jonathan-iap/MiniVarioL0/PCB/README.md

Tool_Kicad-EmptyProject
===============

Empty project for new project based on Kicad
