jonathan-iap/MiniVarioL0/PCB/FAB/BOM/MiniVarioL0_B1.ods

Project |  | MiniVarioL0
Gerber Version |  | v1.0.0
BOM Version |  | B1
PCB Class |  |  |  |  | STACKUP (EuroCircuits dimension en µm)
Epaisseur (mm) |  | 1,6 |  |  | MC4 1.6 | 1 | Cu – SIGNAL |  |  | 35
Track & cleareance min(mm) |  | 150/150 |  |  |  |  | Prepeg (12+18) |  |  | 200
Via Hole min (mm) |  | 0,25 |  |  |  |  | prepeg
Via diam min (mm) |  | 0,6 |  |  |  | 2 | Cu int – GND | 18 |  | 20
PCB color |  | green |  |  |  |  | Core FR4 |  |  | 1065
PCB Dimension (mm) |  | 73.00 x 61.00
Impedance Control |  | no |  |  |  | 3 | Cu int – POWER | 18 |  | 20
 |  |  |  |  |  |  | Prepeg (12+18) |  |  | 200
 |  |  |  |  |  |  | 0,20 mm (1 x 2116 1 x 1080) | 200
 |  |  |  |  |  | 4 | Cu– SIGNAL | 18 |  | 35
 |  |  |  |  |  |  |  |  |  | 1575
id | Component |  | Description |  |  | Case |  | Manufacturer | Reference man |  | quantity | datasheet
1 | BT1 |  | Holder for battery coin cell |  |  | CellCoin_BK-912 |  |  | BK-912 |  | 1
6 | C1,C2,C3,C4 |  | CAP CER 10nF 10 % | CAP CER 10nF 10 % |  | C_0402 |  |  |  |  | 4
7 | C5,C12 |  | CAP CER 10µF 10 % | CAP CER 10µF 10 % |  | C_0603 |  |  |  |  | 2
8 | C6,C7,C8,C9,C10,C11,C13,C14 |  | CAP CER 100nF 10 % | CAP CER 100nF 10 % |  | C_0402 |  |  |  |  | 8
9 | D1,D2 |  | D_Schottky | D_Schottky |  | D_0603 |  |  |  |  | 2
10 | D3 |  | LED | LED |  | LED_0603 |  |  |  |  | 1
11 | FB1 |  | Ferrite_Bead | Ferrite_Bead |  | L_0603 |  |  |  |  | 1
13 | LS1 |  | Speaker_Crystal | Speaker_Crystal |  | Buzzer_PKLCS1212E |  |  | PKLCS1212E |  | 1
14 | Q1 |  | Dual mosfet NP-chan 20V | Dual mosfet NP-chan 20V |  | TSOT-23-6 |  |  | DMC2053UVT |  | 1
15 | R1,R2,R3 |  | RES 1M 1 % 63mW | RES 1M 1 % 63mW |  | R_0402 |  |  |  |  | 3
16 | U3 |  | Barometric Pressure Sensor | Barometric Pressure Sensor |  | LGA-8_3x5mm_Pitch1.25mm |  |  | MS5611-01BA |  | 1
2 | U2 |  | IC MCU 32BIT 64KB FLASH | IC MCU 32BIT 64KB FLASH |  | QFN-32-1EP_5x5mm_Pitch0.5mm |  |  | STM32L071KBUx |  | 1
3 | U1 |  | Piezo sound driver | PAM8904JER |  | UQFN-16-1EP_3x3mm_Pitch0.5mm |  |  | PAM8904JER |  | 1
5 | SW4,SW3,SW1 |  | SW_Push_Dual | SW_Push_Dual |  | KMS233G |  |  | KMS233G |  | 3
 |  |  |  |  |  |  |  |  |  |  | 30
Difference from BOM : B1 to B ?
Remove |  | Add |  | Value changed
