jonathan-iap/MiniVarioL0/PCB/FAB/PDF/MiniVario-B_Fab.pdf

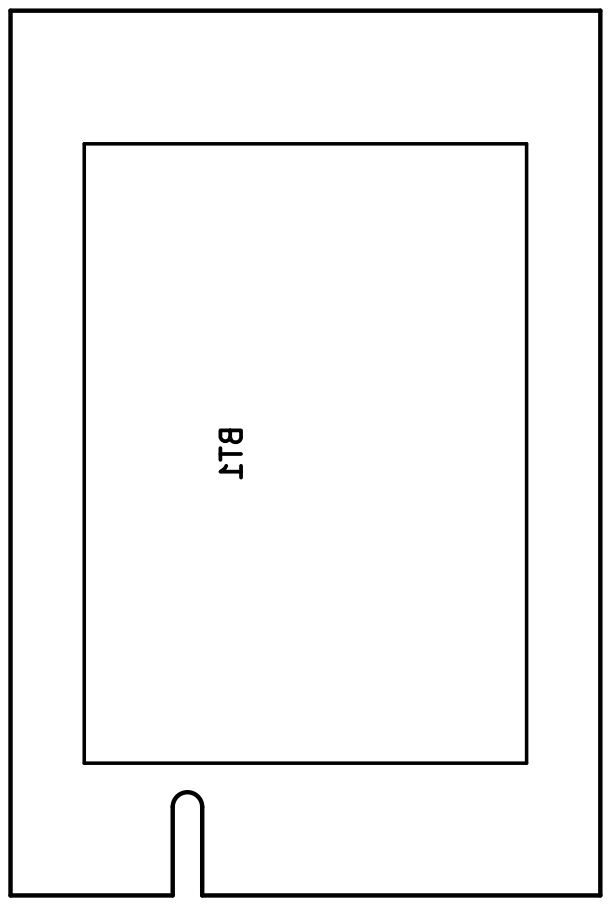
[picture p1: page 1]

File: MiniVario.kicad_pcb Sheet: Jonathan IAPICCO BT1
