jonathan-iap/MiniVarioL0/PCB/FAB/PDF/MiniVario-F_Fab.pdf

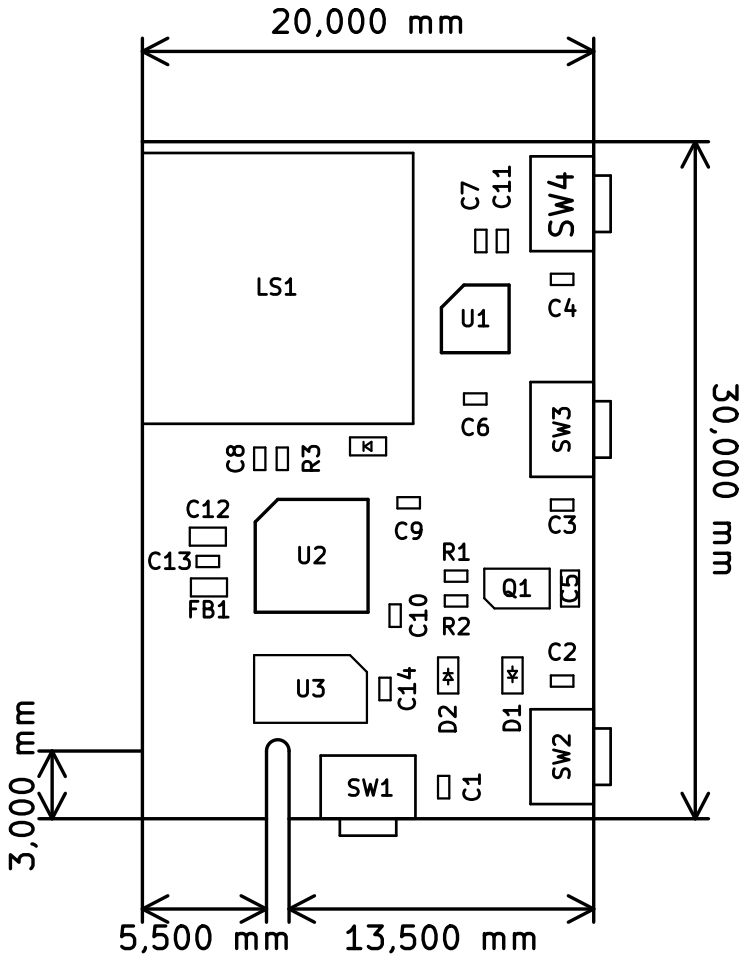
[picture p2: page 1]

File: MiniVario.kicad_pcb Sheet: Jonathan IAPICCO 3,000 mm
