jonathan-iap/MiniVarioL0/PCB/MiniVarioL0.kicad_pcb

## KiCad design PCB/MiniVarioL0.kicad_pcb (2019-11-09)

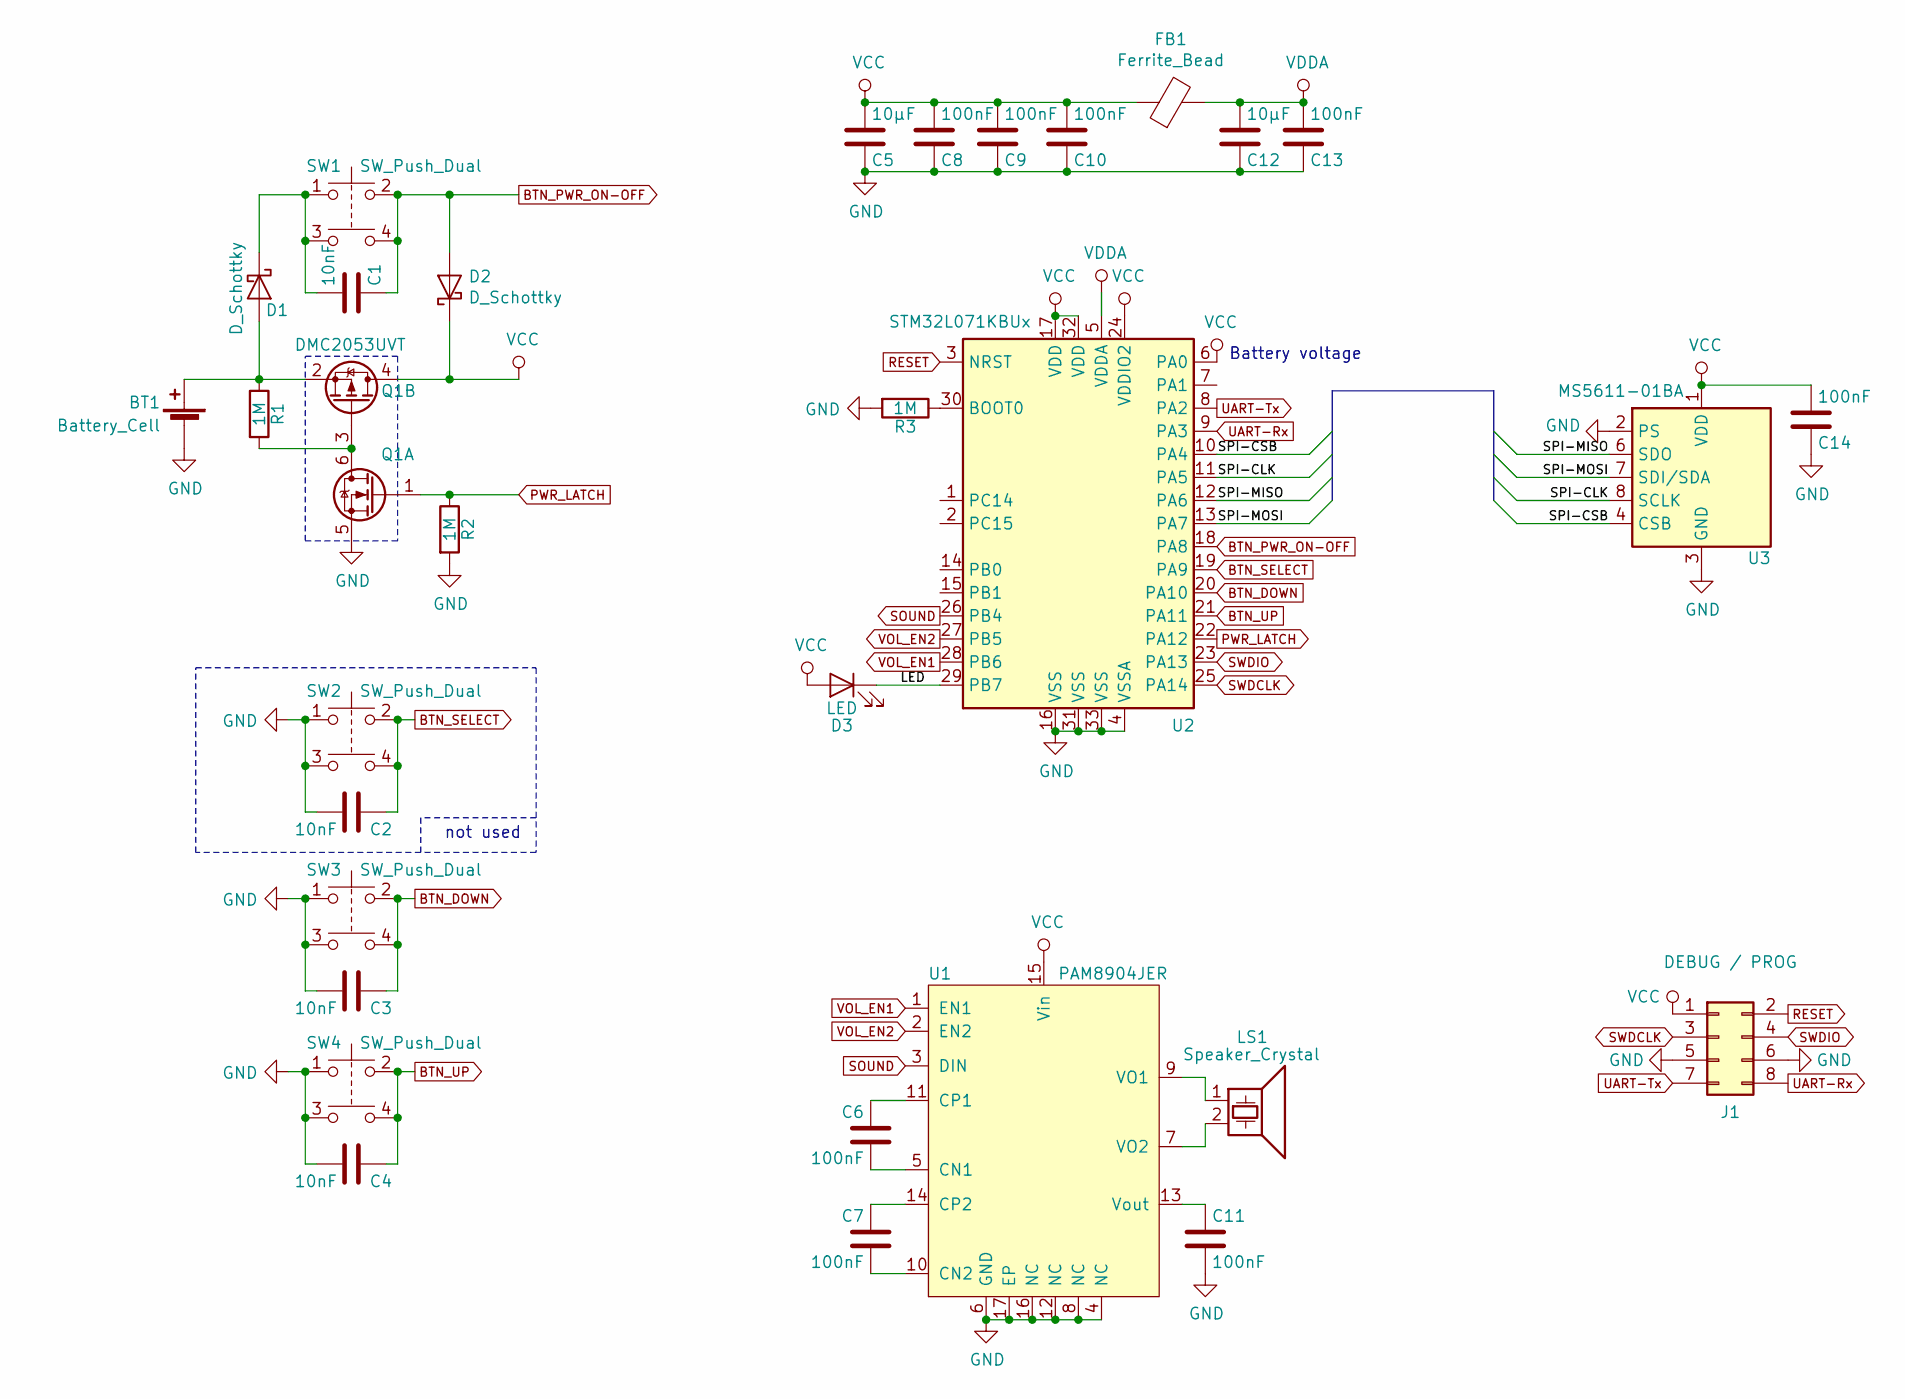
[picture p3: schematic MiniVarioL0.sch]

Parts:
BT1: Battery_Cell; CellCoin_BK-912
C1, C2, C3, C4: 10nF; C_0402
C5, C12: 10µF; C_0603
C6, C7, C8, C9, C10, C11, C13, C14: 100nF; C_0402
D1, D2: D_Schottky; D_0603
D3: LED; LED_0603
FB1: Ferrite_Bead; L_0603
J1: DEBUG / PROG; Conn_Debug
LS1: Speaker_Crystal; Buzzer_PKLCS1212E
Q1: DMC2053UVT; TSOT-23-6
R1, R2, R3: 1M; R_0402
SW1, SW2, SW3, SW4: SW_Push_Dual; PushButton_KMS233G
U1: PAM8904JER; UQFN-16-1EP_3x3mm_Pitch0.5mm
U2: STM32L071KBUx; QFN-32-1EP_5x5mm_Pitch0.5mm
U3: MS5611-01BA; LGA-8_3x5mm_Pitch1.25mm

Connections:
/LED: D3.1 (K), U2.29 (PB7)
/SPI-CLK: U2.11 (PA5), U3.8 (SCLK)
/SPI-CSB: U2.10 (PA4), U3.4 (CSB), U3.5 (CSB)
/SPI-MISO: U2.12 (PA6), U3.6 (SDO)
/SPI-MOSI: U2.13 (PA7), U3.7 (SDI/SDA)
BTN_DOWN: C3.1, SW3.2, SW3.4, U2.20 (PA10)
BTN_PWR_ON-OFF: C1.1, D2.2 (A), SW1.2, SW1.4, U2.18 (PA8)
BTN_SELECT: C2.1, SW2.2, SW2.4, U2.19 (PA9)
BTN_UP: C4.1, SW4.2, SW4.4, U2.21 (PA11)
GND: BT1.2 (-), C2.2, C3.2, C4.2, C5.1, C8.1, C9.1, C10.1, C11.2, C12.1, C13.1, C14.1, J1.5, J1.6, Q1.5 (S), R2.2, R3.2, SW2.1, SW2.3, SW3.1, SW3.3, SW4.1, SW4.3, U1.4 (NC), U1.6 (GND), U1.8 (NC), U1.12 (NC), U1.16 (NC), U1.17 (EP), U2.4 (VSSA), U2.16 (VSS), U2.31 (VSS), U2.33 (VSS), U3.2 (PS), U3.3 (GND)
unnamed: BT1.1 (+), D1.2 (A), Q1.2 (S), R1.1
unnamed: C1.2, D1.1 (K), SW1.1, SW1.3
unnamed: C6.1, U1.11 (CP1)
unnamed: C6.2, U1.5 (CN1)
unnamed: C7.1, U1.14 (CP2)
unnamed: C7.2, U1.10 (CN2)
unnamed: C11.1, U1.13 (Vout)
unnamed: LS1.1, U1.9 (VO1)
unnamed: LS1.2, U1.7 (VO2)
unnamed: Q1.3 (G), Q1.6 (D), R1.2
unnamed: R3.1, U2.30 (BOOT0)
PWR_LATCH: Q1.1 (G), R2.1, U2.22 (PA12)
RESET: J1.2, U2.3 (NRST)
SOUND: U1.3 (DIN), U2.26 (PB4)
SWDCLK: J1.3, U2.25 (PA14)
SWDIO: J1.4, U2.23 (PA13)
UART-Rx: J1.8, U2.9 (PA3)
UART-Tx: J1.7, U2.8 (PA2)
VCC: C5.2, C8.2, C9.2, C10.2, C14.2, D2.1 (K), D3.2 (A), FB1.1, J1.1, Q1.4 (D), U1.15 (Vin), U2.6 (PA0), U2.17 (VDD), U2.24 (VDDIO2), U2.32 (VDD), U3.1 (VDD)
VDDA: C12.2, C13.2, FB1.2, U2.5 (VDDA)
VOL_EN1: U1.1 (EN1), U2.28 (PB6)
VOL_EN2: U1.2 (EN2), U2.27 (PB5)

Notes on the sheet:
Battery voltage
not used

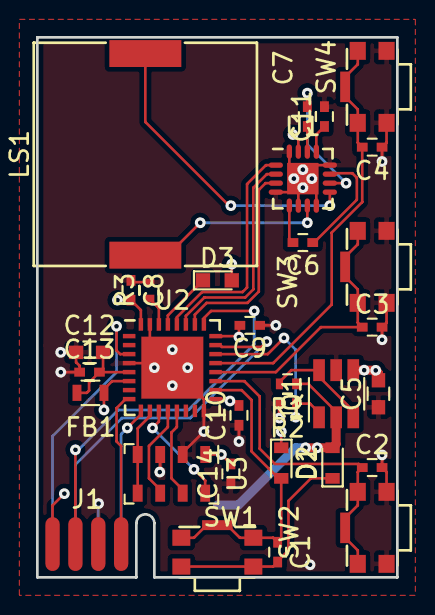
[picture p4: board MiniVarioL0.kicad_pcb from above]

Board: 4 copper layers, 20.0 x 30.0 mm, 32 parts (1 on the bottom side), 32 nets.
