jonathan-iap/MiniVarioL0/Software/Src/main.c

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

/* Includes ------------------------------------------------------------------*/
#include "main.h"
#include "adc.h"
#include "usart.h"
#include "spi.h"
#include "tim.h"
#include "gpio.h"
/* USER CODE BEGIN Includes */
#include "stdio.h"
#include "Peripherals/MS56xx.h"
#include "Peripherals/Tone.h"
#include "Peripherals/UserButtons.h"
#include "Peripherals/Power.h"
#include "Middleware/Macro.h"
#include "Middleware/CheckingHardware.h"
#include "Middleware/Vario.h"
/* USER CODE END Includes */


void SystemClock_Config(void);
/**
 * @brief  The application entry point.
 * @retval int
 */
int main(void)
{
	/* MCU Configuration--------------------------------------------------------*/

	/* Reset of all peripherals, Initializes the Flash interface and the Systick. */
	HAL_Init();

	/* Configure the system clock */
	SystemClock_Config();

	/* Initialize all configured peripherals */
	MX_GPIO_Init();
	MX_SPI1_Init();
	MX_LPUART1_UART_Init();
	MX_ADC_Init();
	MX_TIM3_Init();
	/* USER CODE BEGIN 2 */
#ifdef HARDWARE_TESTING

	checkingHardware(); // Help for new device assembly

	while(1)
	{
		HAL_GPIO_TogglePin(LED_GPIO_Port, LED_Pin);
		HAL_Delay(500);
	}
#endif

	welcome();
	/* USER CODE END 2 */

	/* Infinite loop */
	/* USER CODE BEGIN WHILE */
	while (1)
	{
		varioRun();
		/* USER CODE END WHILE */

		/* USER CODE BEGIN 3 */
	}
	/* USER CODE END 3 */
}

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
