jonathan-iap/MiniVarioL0/Software/Inc/main.h

#define Vbatt_Pin GPIO_PIN_0
#define Vbatt_GPIO_Port GPIOA
#define SPI1_CS_Pin GPIO_PIN_4
#define SPI1_CS_GPIO_Port GPIOA
#define BTN_PWR_ON_OFF_Pin GPIO_PIN_8
#define BTN_PWR_ON_OFF_GPIO_Port GPIOA
#define BTN_SELECT_Pin GPIO_PIN_9
#define BTN_SELECT_GPIO_Port GPIOA
#define BTN_DOWN_Pin GPIO_PIN_10
#define BTN_DOWN_GPIO_Port GPIOA
#define BTN_UP_Pin GPIO_PIN_11
#define BTN_UP_GPIO_Port GPIOA
#define PWR_LATCH_Pin GPIO_PIN_12
#define PWR_LATCH_GPIO_Port GPIOA
#define VOL_EN2_Pin GPIO_PIN_5
#define VOL_EN2_GPIO_Port GPIOB
#define VOL_EN1_Pin GPIO_PIN_6
#define VOL_EN1_GPIO_Port GPIOB
#define LED_Pin GPIO_PIN_7
#define LED_GPIO_Port GPIOB
